hannesduske/Fast_SiPM_Photodetector/03_Design/PCB Desing Calculations.pdf

### LMR516XX Output Voltage

### R ¹º 13 kΩ 1

### R ¹º 1,8 kΩ 2

V ¹º 0,8 V out,ref,LMR516XX

¹º | * V | = 6,5778 V out,ref,LMR516XX + 1
R2

R1 Vout,LMR516XX

¹º | = 0,4444 mA
+ R2

R1

Vout,LMR516XX I

### LMR516XX Enable Threshold

### R ¹º 36 kΩ 1

### R ¹º 2 kΩ 2

V ¹º 1,227 V en,ref,LMR516XX

¹º | * V | = 23,313 V
| R en,ref,LMR516XX
2

+ R2

R1 Ven,LMR516XX

### LT8365 Output Voltage

### R1 ¹º 36 kΩ

### R2 ¹º 2 kΩ

V ¹º 1,6 V out,ref,LT8365

¹º | * V | = 30,4 V out,ref,LT8365 + 1
R2

R1 Vout,LT8365

¹º | = 0,8 mA
+ R2

R1

Vout,LT8365 I

### LT8365 Enable Threshold

### R ¹º 100 kΩ 1

### R ¹º 27 kΩ 2

V ¹º 1,6 V en,ref,LT8365

¹º | * V | = 7,5259 V
| R en,ref,LT8365
2

+ R2

R1 Ven,LT8365

### NCP731 Output Voltage Range

### R ¹º 100 kΩ 1

### R ¹º 4,3 kΩ 2,fix

R ¹º 1 kΩ 2,adj

V ¹º 1,2 V out,ref,NCP731

¹º | * V | = 23,8415 V out,ref,NCP731 + 1
+ R2,adj

R2,fix

R1 Vout,low,NCP731

¹º | * V | = 29,107 V out,ref,NCP731 + 1
R2,fix

R1 Vout,high,NCP731

¹º | = 0,2292 mA
+ R2

R1

Vout,high,NCP731 I

### GALI S66+

### I ¹º 18 mA S66

### V ¹º 3,5 V S66

¹º | = 170,9877 Ω
IS66
- VS66

Vout,LMR516XX RS66

¹º | * I | = 55,4 mW S66
- VS66

Vout,LMR516XX

PR,bias
