hannesduske/Fast_SiPM_Photodetector/01_Docs/01_Img/output_noise_floor.png

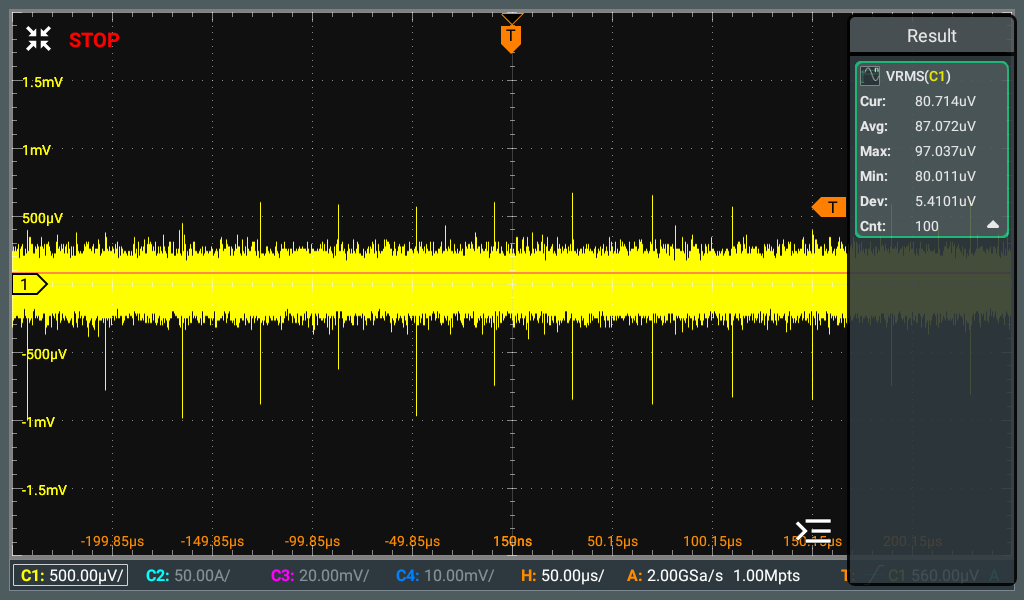
01_Docs/01_Img/output_noise_floor.png
