hannesduske/Fast_SiPM_Photodetector/01_Docs/01_Img/pcb_v0_2_asm.png

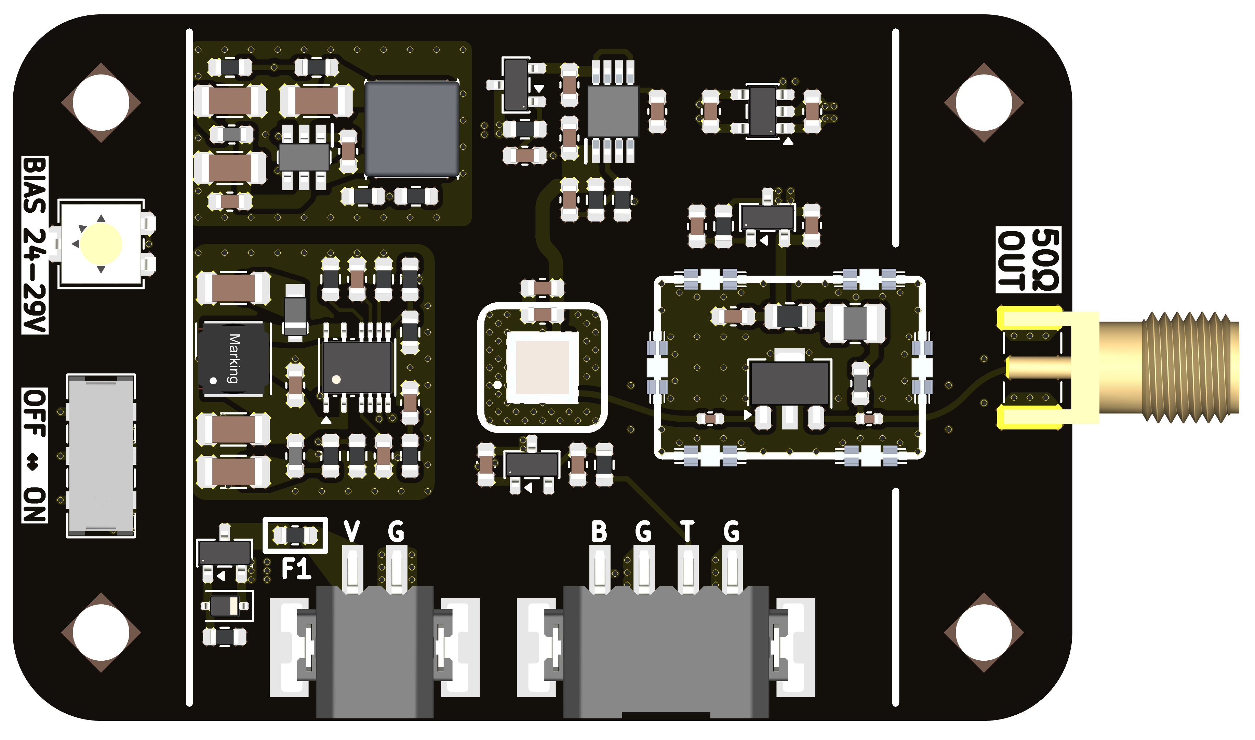
01_Docs/01_Img/pcb_v0_2_asm.png
