hannesduske/Fast_SiPM_Photodetector/02_PCB/Fast_SiPM_Photodetector/Fabrication/V0.2/Fast_SiPM_Photodetector-V0.2-bom.csv

Designator | Footprint | Quantity | Value | LCSC Part #
C1, C10, C2, C27, C28, C7 | 1206 | 6 | 10u;50V
C11, C13, C17, C18, C23, C24 | 0603 | 6 | 2.2u;35V
C12, C19, C25, C29, C3, C9 | 0603 | 6 | 100n;100V
C14, C15, C16, C21, C26 | 0603 | 5 | 10n;100V
C20, C22 | 0402 | 2 | 10nF;25V;C0G
C4 | 0603 | 1 | 1u;16V
C5 | 0603 | 1 | 1n;16V
C6 | 0603 | 1 | 220n;16V
D1 | D_SOD-323 | 1 | SZMM3Z10VT1G
D2 | SMD115PBQTP | 1 | RB021VAM90TR
F1 | 0603 | 1 | MFU0603FF03000
FB1, FB3 | 0603 | 2 | BLM18AG601SN1D
IC1 | Analog_MSOP-12-16-1EP_3x4.039mm_P0.5mm_EP1.651x2.845mm | 1 | LT8365JMSE
IC2 | SOT95P280X145-6N | 1 | LMR51606XFDBVR
IC3 | MICROFC30035SMTTR1 | 1 | MICROFC-30035-SMT-TR1
IC4 | SOP65P488X110-9N | 1 | NCP731ADNADJR2G
J1 | PTSM 0,5 2-HH-2,5-SMD R32 | 1 | PTSM 0,5/ 2-HH-2,5-SMD R32
J2 | SMA_Samtec_SMA-J-P-H-ST-EM1_EdgeMount | 1 | SMA
J3 | PTSM 0,5 4-HH-2,5-SMD R32 | 1 | PTSM 0,5/ 4-HH-2,5-SMD R32
L1 | L_Wurth_WE-LQSH-4020 | 1 | 7443732448100
L2 | L_Wuerth_MAPI-5020-Custom | 1 | 74404052470
L3 | 1008 | 1 | 1008CS-222XGRC
L4 | 0603 | 1 | 0603HP-R10XGRW
MP1, MP2, MP3, MP4, MP5, MP6 | S094146R | 6 | S0941-46R
Q1 | SOT-23 | 1 | PJA3463_R1_00001
Q2, Q3 | SOT-23 | 2 | MMBT6427LT1G
R1, R13, R14, R16, R3, R7 | 0603 | 6 | 100k;1%
R10, R12, R6 | 0603 | 3 | 2k;1%
R11 | 0603 | 1 | 13k;1%
R15 | 0603 | 1 | 4.3k;1%
R17 | 0805 | 1 | 169;1%
R18 | 0603 | 1 | 10k;1%
R2 | 0603 | 1 | 91k;1%
R4 | 0603 | 1 | 130k;1%
R5, R9 | 0603 | 2 | 36k;1%
R8 | 0603 | 1 | 27k;1%
RV1 | Potentiometer_Bourns_3214J_Horizontal | 1 | 3314J-1-102
SW1 | SW_DPDT_CK_JS202011JCQN | 1 | JS202011JCQN
U1 | SOT-89-3 | 1 | GALI-S66
U2 | SOT-23-5 | 1 | TLV70033DDCR
U3 | SOT-23 | 1 | MCP9700Ax-ETT
