hannesduske/Fast_SiPM_Photodetector/02_PCB/Fast_SiPM_Photodetector/Fabrication/V0.2/Fast_SiPM_Photodetector_V0.2.step

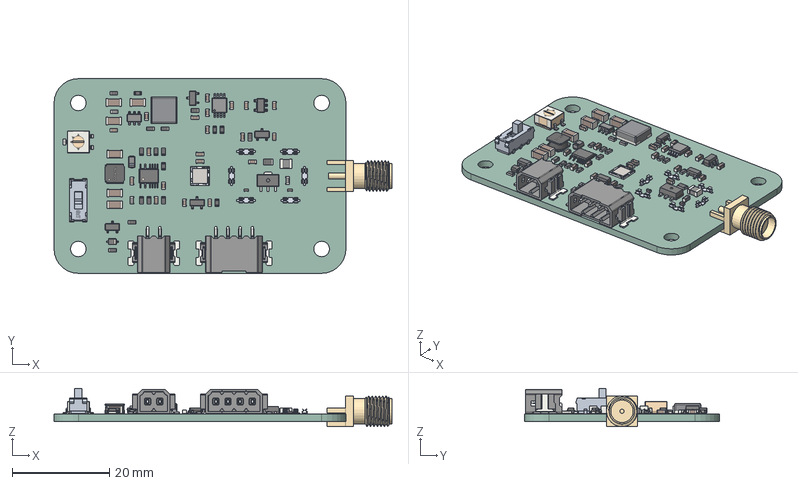
[picture p32: CAD file, 2026-10-15]
02_PCB/Fast_SiPM_Photodetector/Fabrication/V0.2/Fast_SiPM_Photodetector_V0.2.step
69.5 x 40.0 x 7.89 mm
Potentiometer_Bourns_3314G_Vertical
R_0603_1608Metric x 17
S0941-46R x 6
C_0603_1608Metric x 20
Analog_MSOP-12-16-1EP_3x4.039mm_P0.5mm_EP1.651x2.845mm
SOT-23 x 4
D_SOD-323
MICROFC-30035-SMT-TR1
C_1206_3216Metric x 6
Fuse_0603_1608Metric
L_0603_1608Metric x 3
adbeea57-9c39-11ed-93f0-dde97e994e83_part
adbeea58-9c39-11ed-93f0-dde97e994e83_part
adbeea59-9c39-11ed-93f0-dde97e994e83_part
BODY-SOT
LEAD-SOT x 6
L_Wuerth_MAPI-5020
C_0402_1005Metric x 2
PinsArrayLR
ThermalPad
L_1008_2520Metric
SOT-23-5
SMD115PBQ-TP
L_Wurth_WE-LQSH-4020
R_0805_2012Metric
JS202011JCQN_SW0001_PRT
SMA_Samtec_SMA-J-P-H-ST-EM1_EdgeMount
Fast_SiPM_Photodetector_PCB
