hannesduske/Fast_SiPM_Photodetector/02_PCB/Fast_SiPM_Photodetector/Fabrication/V0.1/Fast_SiPM_Photodetector-V0.1.step

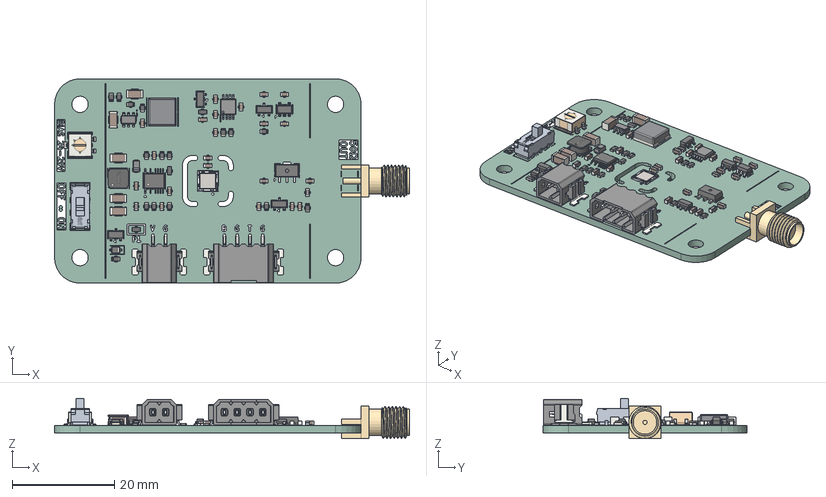
[picture p33: CAD file, 2026-10-15, an earlier design]
02_PCB/Fast_SiPM_Photodetector/Fabrication/V0.1/Fast_SiPM_Photodetector-V0.1.step
69.5 x 40.0 x 7.89 mm
Potentiometer_Bourns_3314G_Vertical
R_0603_1608Metric x 18
C_0603_1608Metric x 21
Analog_MSOP-12-16-1EP_3x4.039mm_P0.5mm_EP1.651x2.845mm
SOT-23 x 4
D_SOD-323
C_1206_3216Metric x 5
MICROFC-30035-SMT-TR1
Fuse_0603_1608Metric
L_0603_1608Metric x 2
adbeea57-9c39-11ed-93f0-dde97e994e83_part
adbeea58-9c39-11ed-93f0-dde97e994e83_part
adbeea59-9c39-11ed-93f0-dde97e994e83_part
BODY-SOT
LEAD-SOT x 6
L_Wuerth_MAPI-5020
PinsArrayLR
ThermalPad
SOT-23-5
SMD115PBQ-TP
L_Wurth_WE-LQSH-4020
JS202011JCQN_SW0001_PRT
SMA_Samtec_SMA-J-P-H-ST-EM1_EdgeMount
SinglePhotonDetector-unsaved-export-c5Gd0f_silkscreen x 2
SinglePhotonDetector-unsaved-export-c5Gd0f_PCB
