hannesduske/Fast_SiPM_Photodetector/02_PCB/Fast_SiPM_Photodetector/Fabrication/V0.2/Fast_SiPM_Photodetector-V0.2-top.jpg

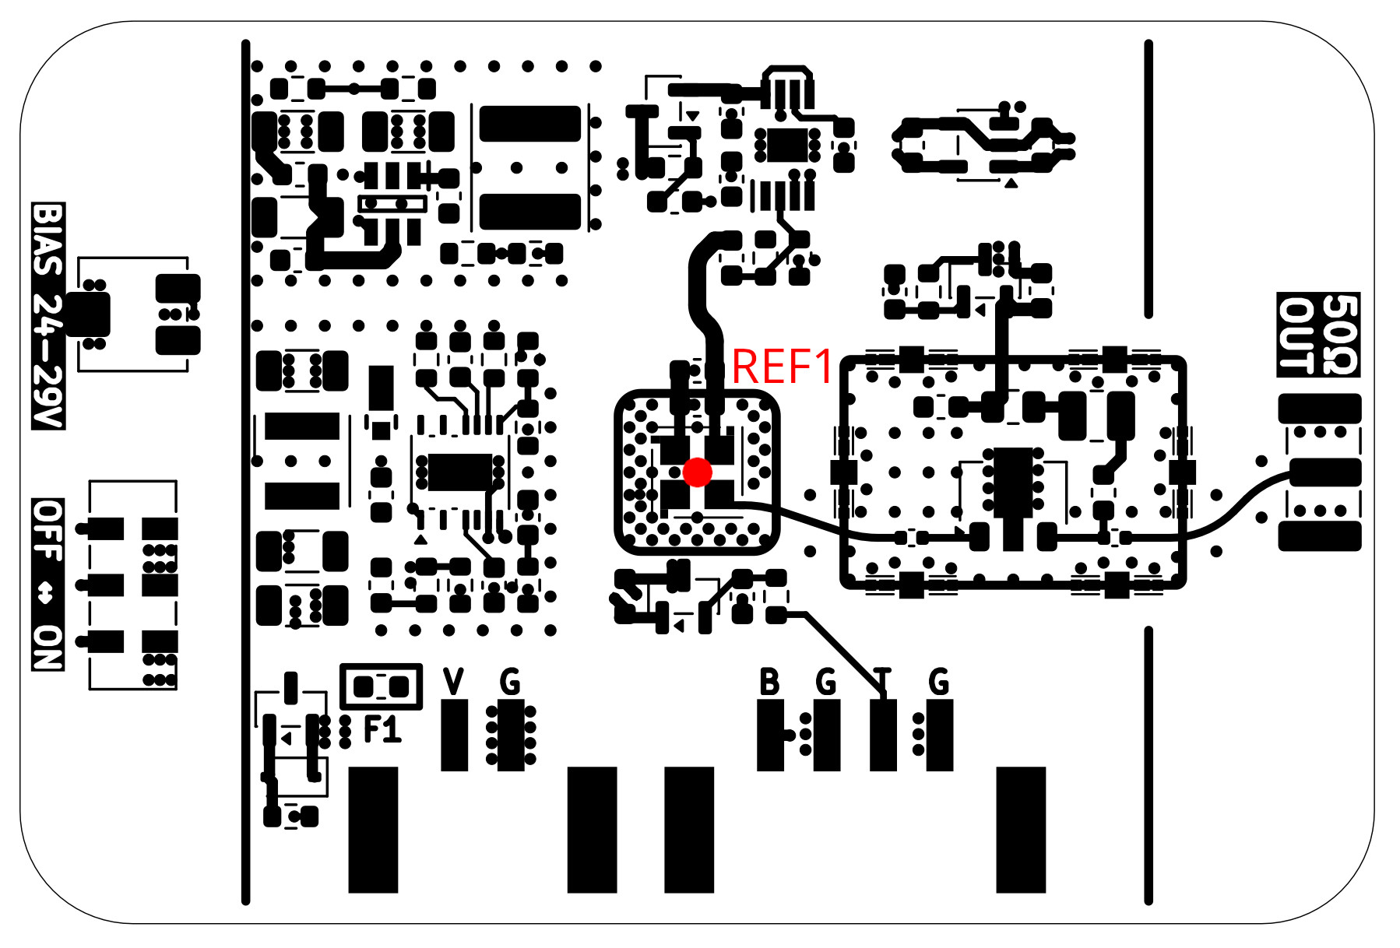
02_PCB/Fast_SiPM_Photodetector/Fabrication/V0.2/Fast_SiPM_Photodetector-V0.2-top.jpg
