hannesduske/Fast_SiPM_Photodetector/04_Evaluation/00_Single_Photon_Detection/single_photon.csv

Bias Voltage [V] | Single Photon Signal Amplitude [mV]
26 | 1
26.5 | 1.4
27 | 1.7
27.5 | 2
28 | 2.4
28.5 | 2.8
29 | 3.1
