hannesduske/Fast_SiPM_Photodetector/04_Evaluation/01_Dark_Count/dark_count.csv

Timebase (µs) | 20
Dark Count (count per 10 Timebase intervals)
Temp °C | 27 V | 28 V | 29 V
23 | 47.5 | 68.2 | 87
22 | 44 | 63.8 | 81.7
21 | 41 | 58.7 | 75.6
20 | 37.5 | 54.5 | 71.5
19 | 34.9 | 51 | 66.5
18 | 33 | 47.8 | 61.4
17 | 30.7 | 44.7 | 56.9
16 | 28.2 | 40.8 | 52.8
15 | 25.9 | 37.4 | 50
14 | 24.1 | 34 | 46.5
13 | 22.5 | 31.9 | 43.8
12 | 20.4 | 30.3 | 40.5
11 | 19.4 | 28.5 | 37.4
10 | 18.2 | 26.3 | 35.8
9 | 17 | 24.7 | 34
