hannesduske/Fast_SiPM_Photodetector/03_Design/capacitor_multiplier.asc

C1: cap; 4.7µ
C2: cap; 1µ
C3: cap; 10µ
Q1: npn
R1: res; 200k
R2: res; 9k
R3: res; 5k
R4: res; 100k
U1: ADM7171
V1: voltage; SINE(33 100m 330k)
Named nets: 0, OUT
.tran 50u
