hannesduske/Fast_SiPM_Photodetector/02_PCB/Fast_SiPM_Photodetector/Fast_SiPM_Photodetector.kicad_pcb

## KiCad design 02_PCB/Fast_SiPM_Photodetector/Fast_SiPM_Photodetector.kicad_pcb (2026-10-14)

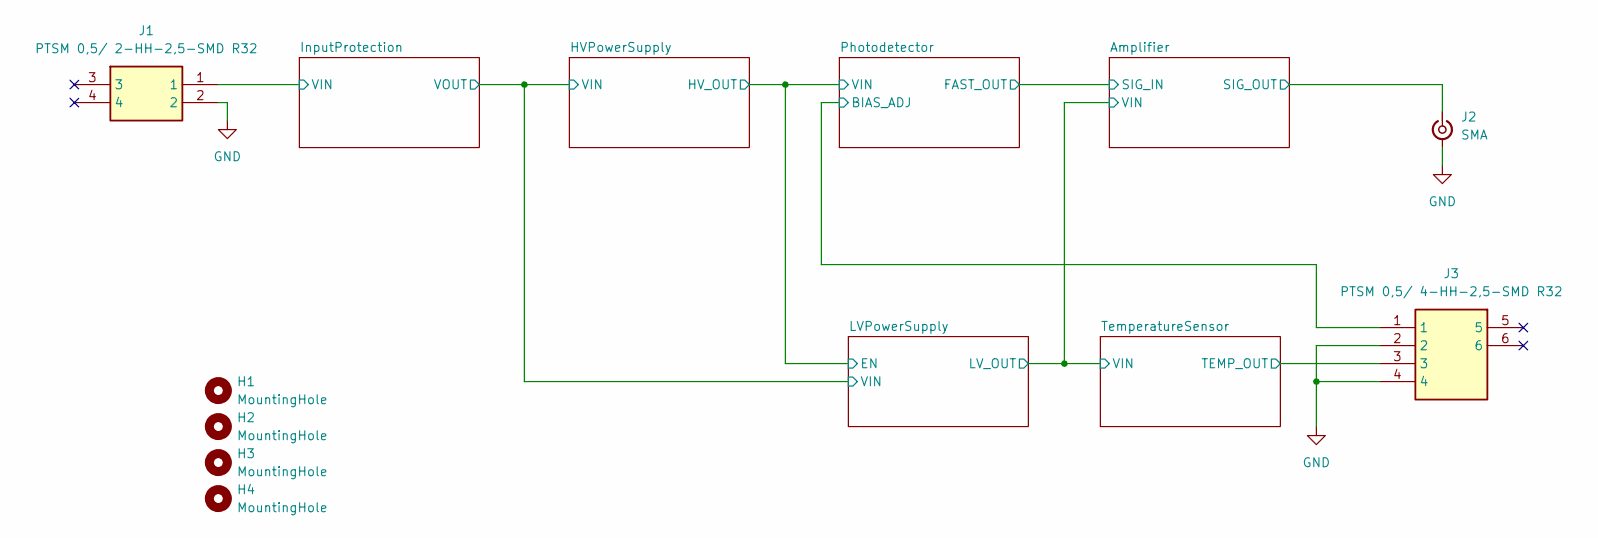
[picture p42: schematic Fast_SiPM_Photodetector.kicad_sch, Fast SiPM Photodetector]

Parts:
H1, H2, H3, H4: MountingHole; MountingHole_3.2mm_M3
J1: PTSM 0,5/ 2-HH-2,5-SMD R32; PTSM 0,5 2-HH-2,5-SMD R32; Mouser Part Number 651-1778764
J2: SMA; SMA_Samtec_SMA-J-P-H-ST-EM1_EdgeMount
J3: PTSM 0,5/ 4-HH-2,5-SMD R32; PTSM 0,5 4-HH-2,5-SMD R32; Mouser Part Number 651-1778780

Connections:
/Amplifier/SIG_OUT: J2.1 (In); also elsewhere on the board
/InputProtection/VIN: J1.1; also elsewhere on the board
/Photodetector/BIAS_ADJ: J3.1; also elsewhere on the board
/TemperatureSensor/TEMP_OUT: J3.3; also elsewhere on the board
GND: J1.2, J2.2 (Ext), J3.2, J3.4; also elsewhere on the board

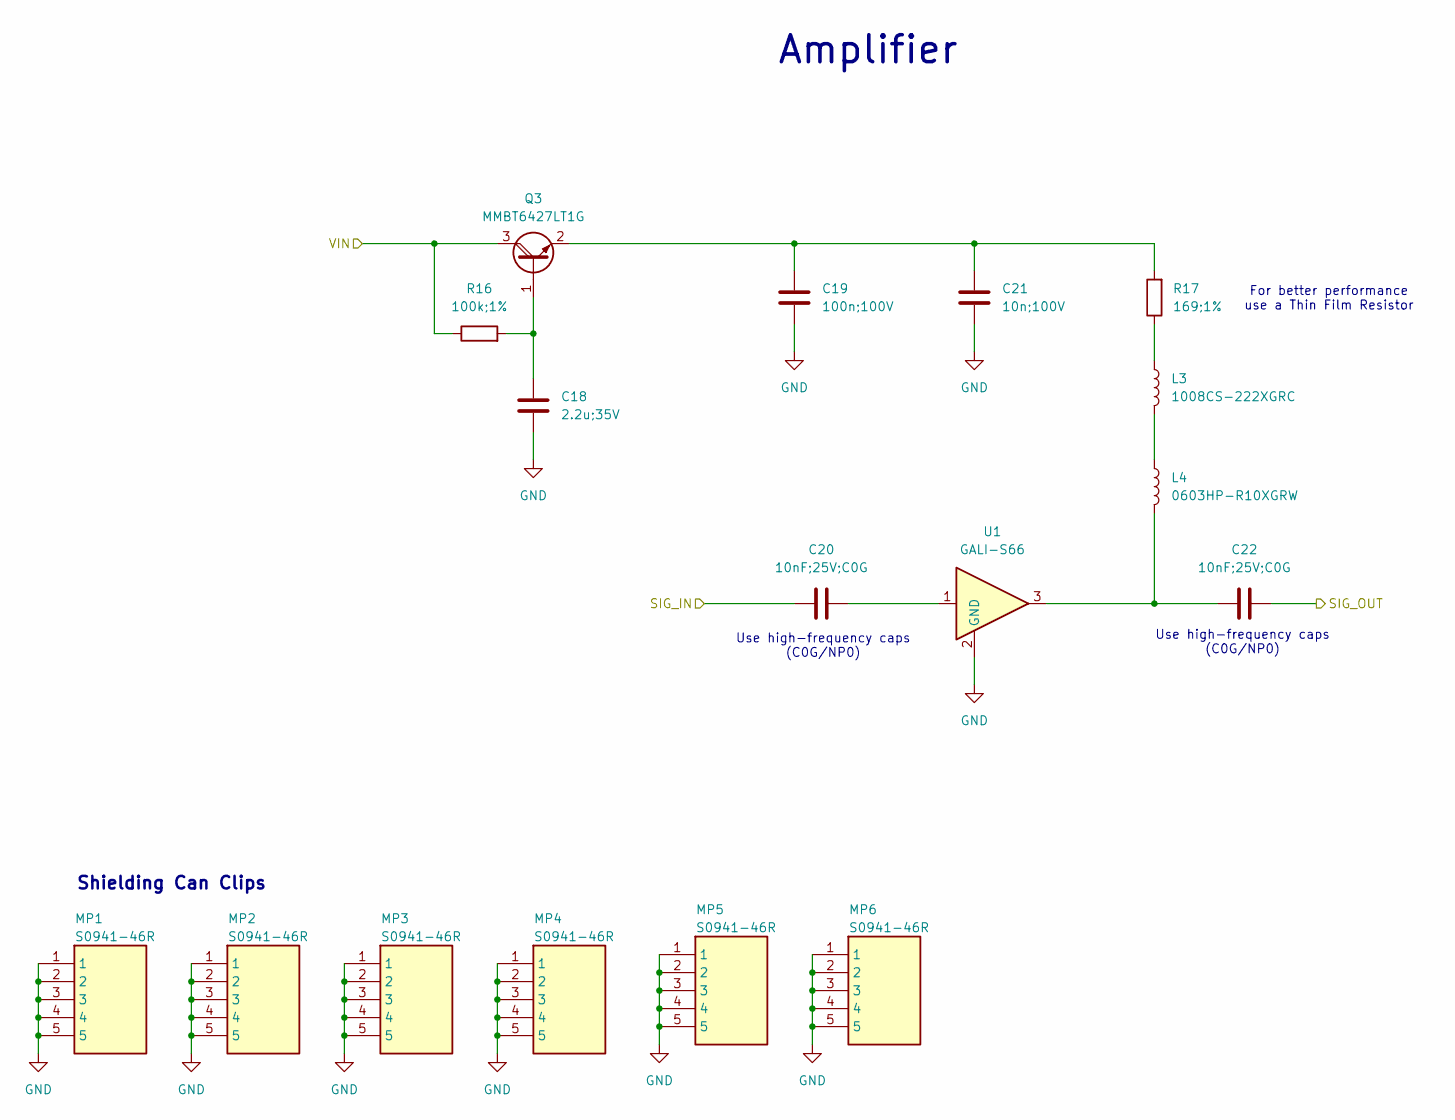
[picture p43: schematic Amplifier.kicad_sch, Fast SiPM Photodetector]

Parts:
C18: 2.2u;35V; C_0603_1608Metric
C19: 100n;100V; C_0603_1608Metric
C20, C22: 10nF;25V;C0G; C_0402_1005Metric
C21: 10n;100V; C_0603_1608Metric
L3: 1008CS-222XGRC; L_1008_2520Metric
L4: 0603HP-R10XGRW; L_0603_1608Metric
MP1, MP2, MP3, MP4, MP5, MP6: S0941-46R; S094146R; Mouser Part Number 855-S0941-46R
Q3: MMBT6427LT1G; SOT-23
R16: 100k;1%; R_0603_1608Metric
R17: 169;1%; R_0805_2012Metric
U1: GALI-S66; SOT-89-3

Connections:
/Amplifier/SIG_IN: C20.1; also elsewhere on the board
/Amplifier/SIG_OUT: C22.2; also elsewhere on the board
/LVPowerSupply/LV_OUT: Q3.3 (C), R16.1; also elsewhere on the board
GND: C18.2, C19.2, C21.2, MP1.1, MP1.2, MP1.3, MP1.4, MP1.5, MP2.1, MP2.2, MP2.3, MP2.4, MP2.5, MP3.1, MP3.2, MP3.3, MP3.4, MP3.5, MP4.1, MP4.2, MP4.3, MP4.4, MP4.5, MP5.1, MP5.2, MP5.3, MP5.4, MP5.5, MP6.1, MP6.2, MP6.3, MP6.4, MP6.5, U1.2 (GND_2); also elsewhere on the board
unnamed: C20.2, U1.1
unnamed: C22.1, L4.2, U1.3
unnamed: L3.1, R17.1
unnamed: L3.2, L4.1
unnamed: C18.1, Q3.1 (B), R16.2
unnamed: C19.1, C21.1, Q3.2 (E), R17.2

Notes on the sheet:
Use high-frequency caps (C0G/NP0)
Shielding Can Clips
For better performance use a Thin Film Resistor
Amplifier

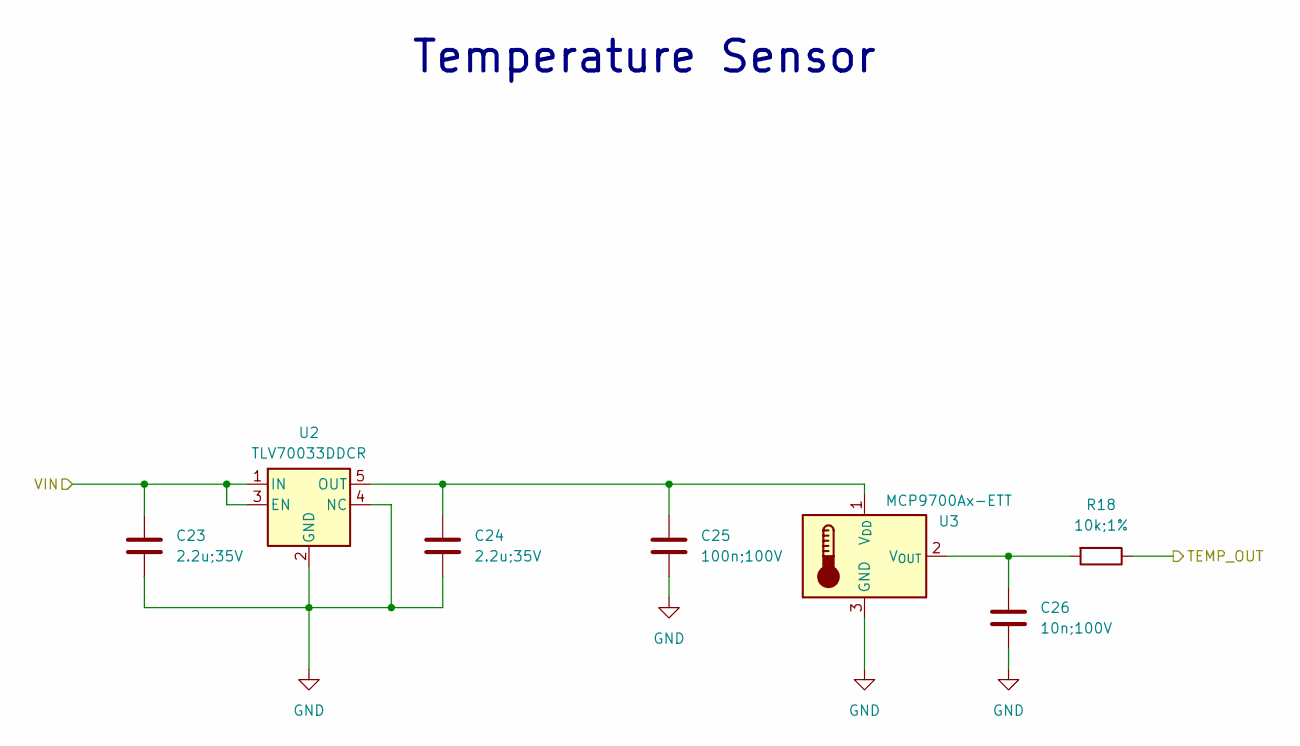
[picture p44: schematic TemperatureSensor.kicad_sch, Fast SiPM Photodetector]

Parts:
C23, C24: 2.2u;35V; C_0603_1608Metric
C25: 100n;100V; C_0603_1608Metric
C26: 10n;100V; C_0603_1608Metric
R18: 10k;1%; R_0603_1608Metric
U2: TLV70033DDCR; SOT-23-5
U3: MCP9700Ax-ETT; SOT-23

Connections:
/LVPowerSupply/LV_OUT: C23.1, U2.1 (IN), U2.3 (EN); also elsewhere on the board
/TemperatureSensor/TEMP_OUT: R18.1; also elsewhere on the board
GND: C23.2, C24.2, C25.2, C26.2, U2.2 (GND), U2.4 (NC), U3.3 (GND); also elsewhere on the board
unnamed: C24.1, C25.1, U2.5 (OUT), U3.1 (V_{DD})
unnamed: C26.1, R18.2, U3.2 (V_{OUT})

Notes on the sheet:
Temperature Sensor

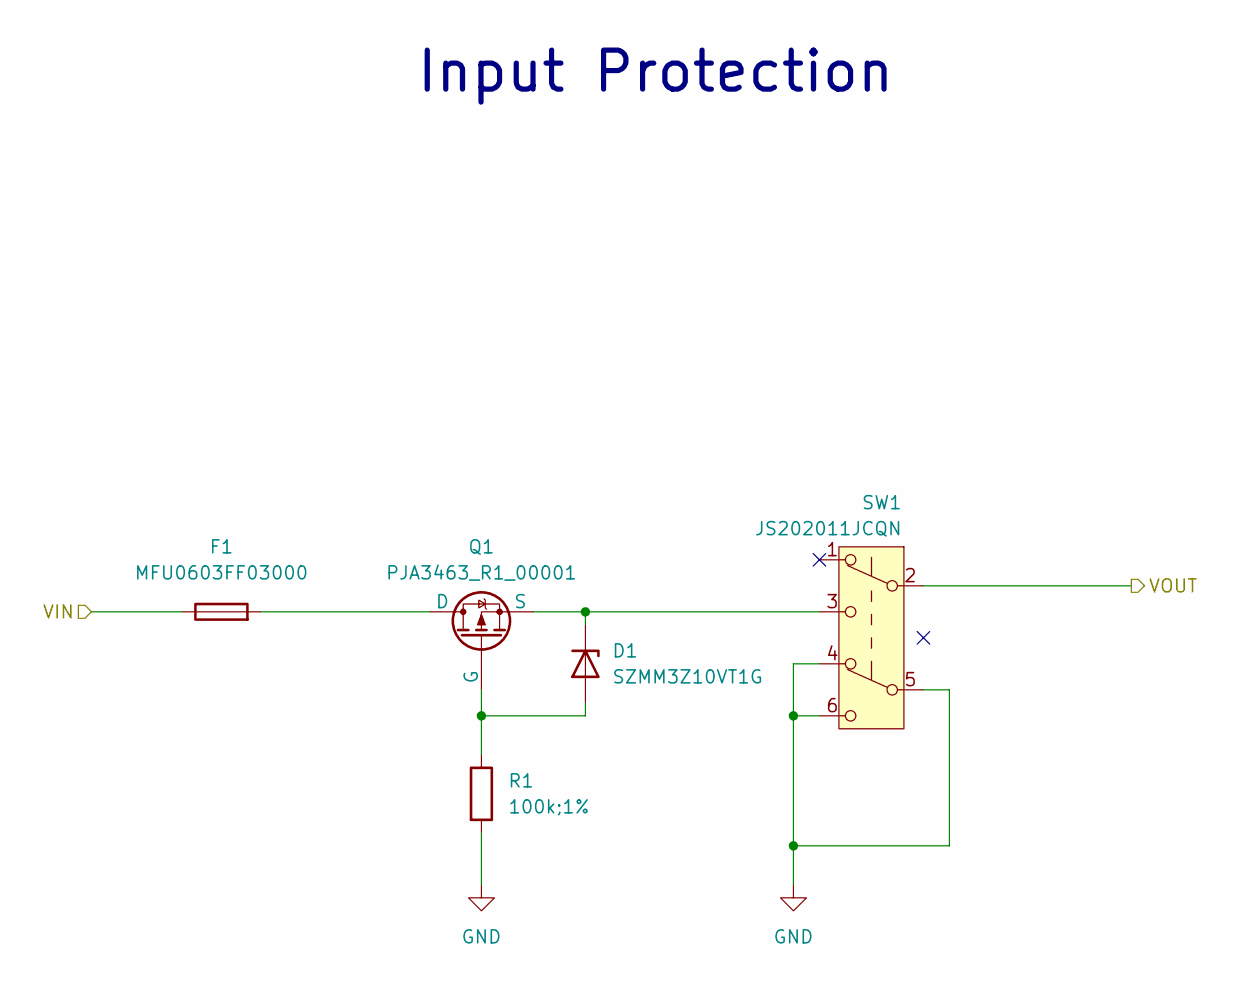
[picture p45: schematic InputProtection.kicad_sch, Fast SiPM Photodetector]

Parts:
D1: SZMM3Z10VT1G; D_SOD-323
F1: MFU0603FF03000; Fuse_0603_1608Metric
Q1: PJA3463_R1_00001; SOT-23
R1: 100k;1%; R_0603_1608Metric
SW1: JS202011JCQN; SW_DPDT_CK_JS202011JCQN

Connections:
/HVPowerSupply/VIN: SW1.2 (B); also elsewhere on the board
/InputProtection/VIN: F1.1; also elsewhere on the board
GND: R1.2, SW1.4 (A), SW1.5 (B), SW1.6 (C); also elsewhere on the board
unnamed: D1.2 (A), Q1.1 (G), R1.1
unnamed: D1.1 (K), Q1.2 (S), SW1.3 (C)
unnamed: F1.2, Q1.3 (D)

Notes on the sheet:
Input Protection

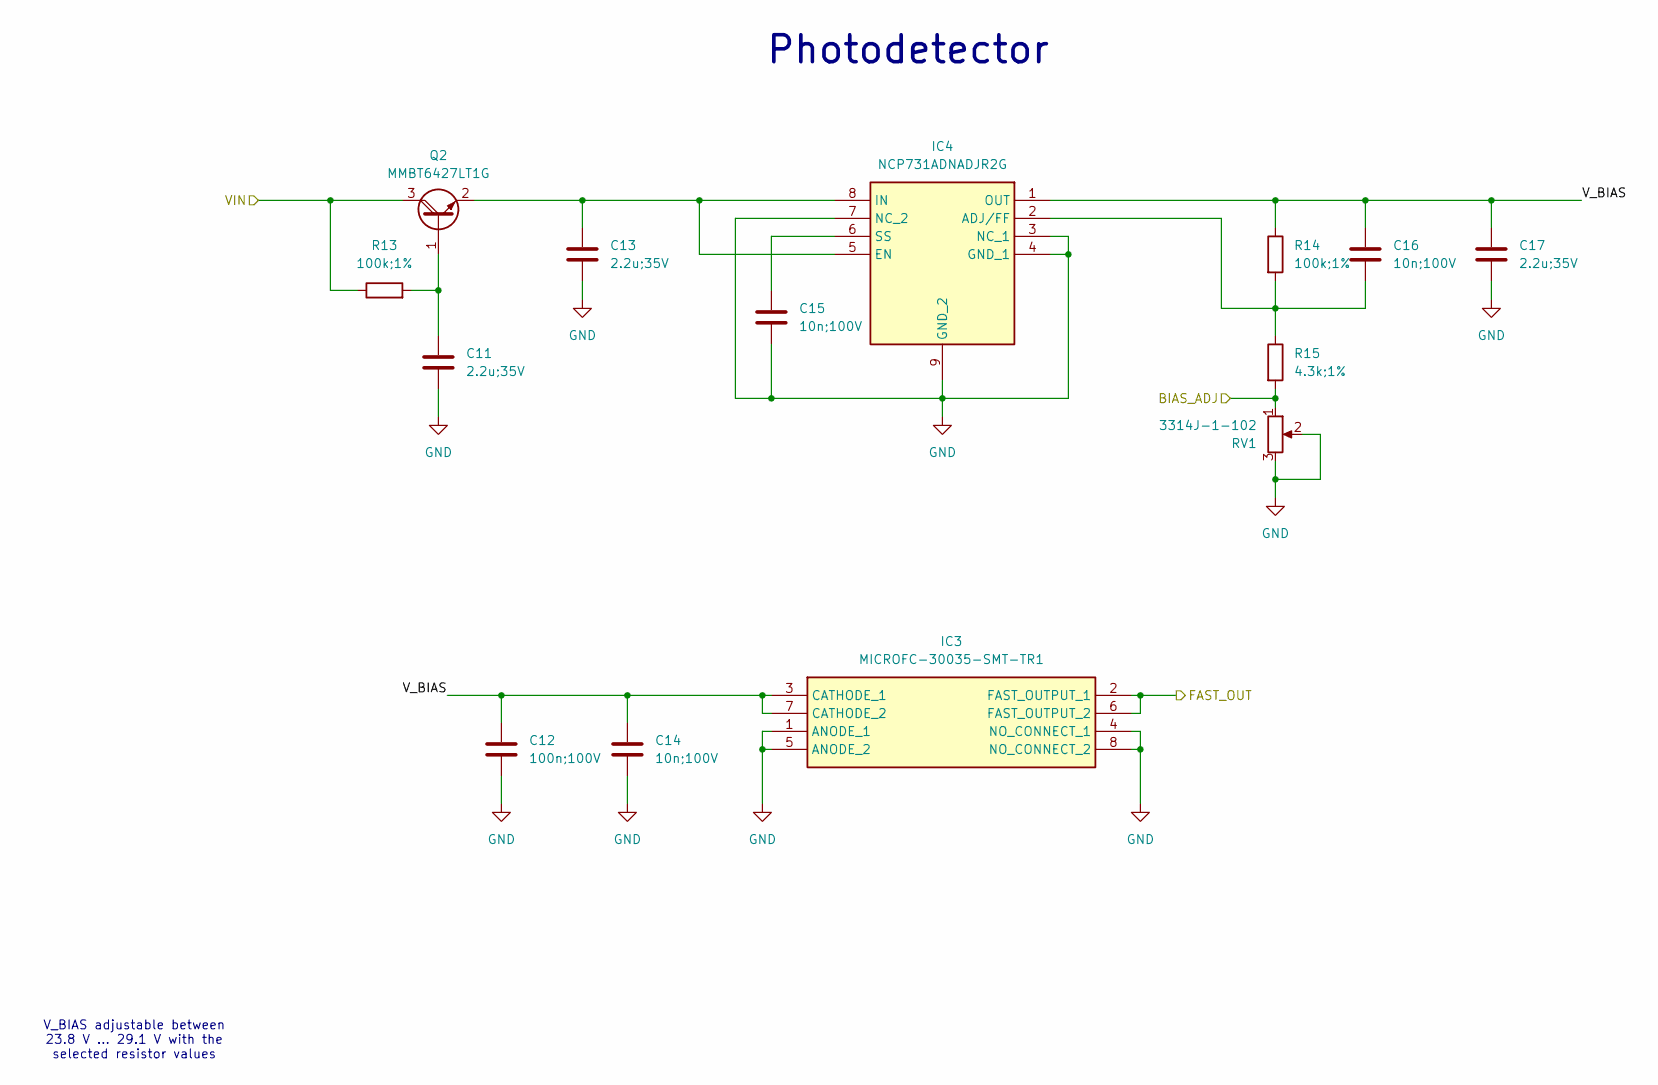
[picture p46: schematic Photodetector.kicad_sch, Fast SiPM Photodetector]

Parts:
C11, C13, C17: 2.2u;35V; C_0603_1608Metric
C12: 100n;100V; C_0603_1608Metric
C14, C15, C16: 10n;100V; C_0603_1608Metric
IC3: MICROFC-30035-SMT-TR1; MICROFC30035SMTTR1; Manufacturer_Part_Number MICROFC-30035-SMT-TR1; Mouser Part Number 863-MFC30035SMTTR1
IC4: NCP731ADNADJR2G; SOP65P488X110-9N; Mouser Part Number 863-NCP731ADNADJR2G
Q2: MMBT6427LT1G; SOT-23
R13, R14: 100k;1%; R_0603_1608Metric
R15: 4.3k;1%; R_0603_1608Metric
RV1: 3314J-1-102; Potentiometer_Bourns_3214J_Horizontal

Connections:
/Amplifier/SIG_IN: IC3.2 (FAST_OUTPUT_1), IC3.6 (FAST_OUTPUT_2); also elsewhere on the board
/HVPowerSupply/HV_OUT: Q2.3 (C), R13.1; also elsewhere on the board
/Photodetector/BIAS_ADJ: R15.2, RV1.1; also elsewhere on the board
/Photodetector/V_BIAS: C12.1, C14.1, C16.1, C17.1, IC3.3 (CATHODE_1), IC3.7 (CATHODE_2), IC4.1 (OUT), R14.1
GND: C11.2, C12.2, C13.2, C14.2, C15.2, C17.2, IC3.1 (ANODE_1), IC3.4 (NO_CONNECT_1), IC3.5 (ANODE_2), IC3.8 (NO_CONNECT_2), IC4.3 (NC_1), IC4.4 (GND_1), IC4.7 (NC_2), IC4.9 (GND_2), RV1.2, RV1.3; also elsewhere on the board
unnamed: C16.2, IC4.2 (ADJ/FF), R14.2, R15.1
unnamed: C13.1, IC4.5 (EN), IC4.8 (IN), Q2.2 (E)
unnamed: C15.1, IC4.6 (SS)
unnamed: C11.1, Q2.1 (B), R13.2

Notes on the sheet:
V_BIAS adjustable between 23.8 V ... 29.1 V with the selected resistor values
Photodetector

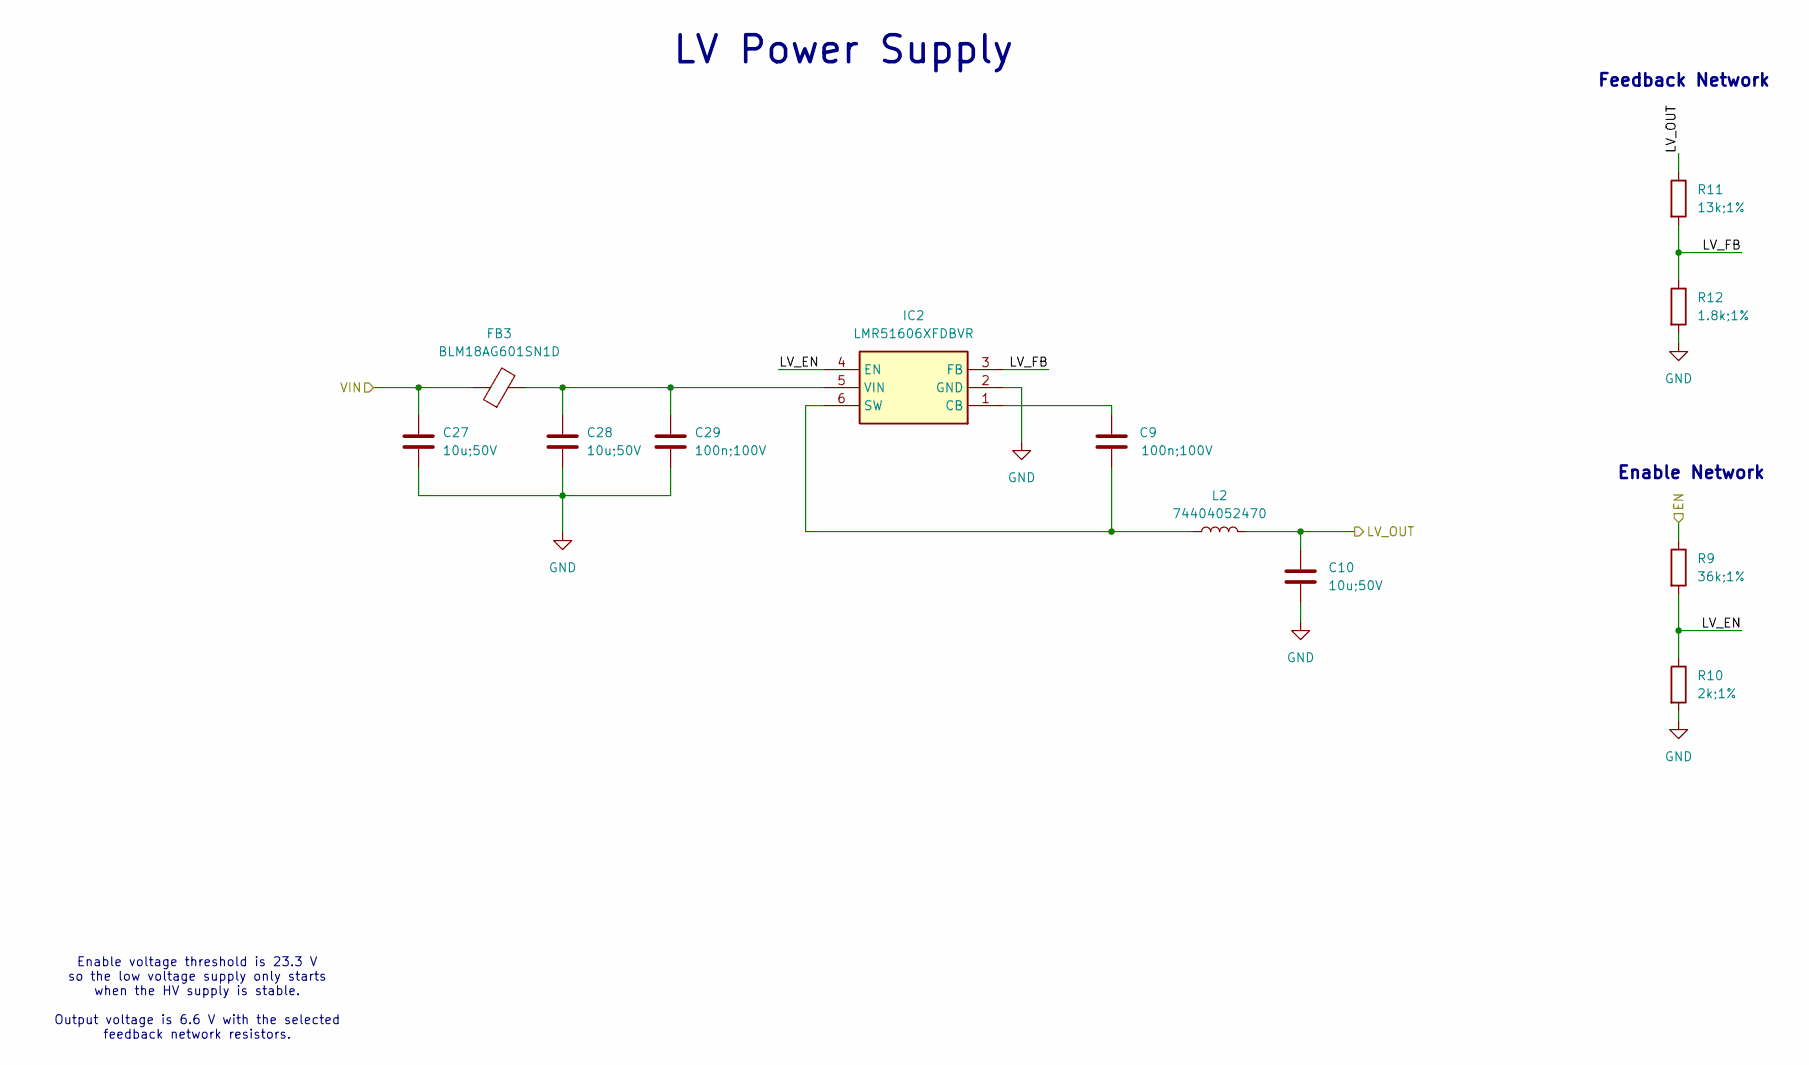
[picture p47: schematic LVPowerSupply.kicad_sch, Fast SiPM Photodetector]

Parts:
C9, C29: 100n;100V; C_0603_1608Metric
C10, C27, C28: 10u;50V; C_1206_3216Metric
FB3: BLM18AG601SN1D; L_0603_1608Metric
IC2: LMR51606XFDBVR; SOT95P280X145-6N; Mouser Part Number 595-LMR51606XDBVR
L2: 74404052470; L_Wuerth_MAPI-5020-Custom
R9: 36k;1%; R_0603_1608Metric
R10: 2k;1%; R_0603_1608Metric
R11: 13k;1%; R_0603_1608Metric
R12: 1.8k;1%; R_0603_1608Metric

Connections:
/HVPowerSupply/HV_OUT: R9.1; also elsewhere on the board
/HVPowerSupply/VIN: C27.2, FB3.1; also elsewhere on the board
/LVPowerSupply/LV_EN: IC2.4 (EN), R9.2, R10.1
/LVPowerSupply/LV_FB: IC2.3 (FB), R11.2, R12.1
/LVPowerSupply/LV_OUT: C10.1, L2.2, R11.1; also elsewhere on the board
GND: C10.2, C27.1, C28.1, C29.1, IC2.2 (GND), R10.2, R12.2; also elsewhere on the board
unnamed: C9.1, IC2.1 (CB)
unnamed: C9.2, IC2.6 (SW), L2.1
unnamed: C28.2, C29.2, FB3.2, IC2.5 (VIN)

Notes on the sheet:
Enable Network
Feedback Network
LV Power Supply
Enable voltage threshold is 23.3 V so the low voltage supply only starts when the HV supply is stable. Output voltage is 6.6 V with the selected feedback network resistors.

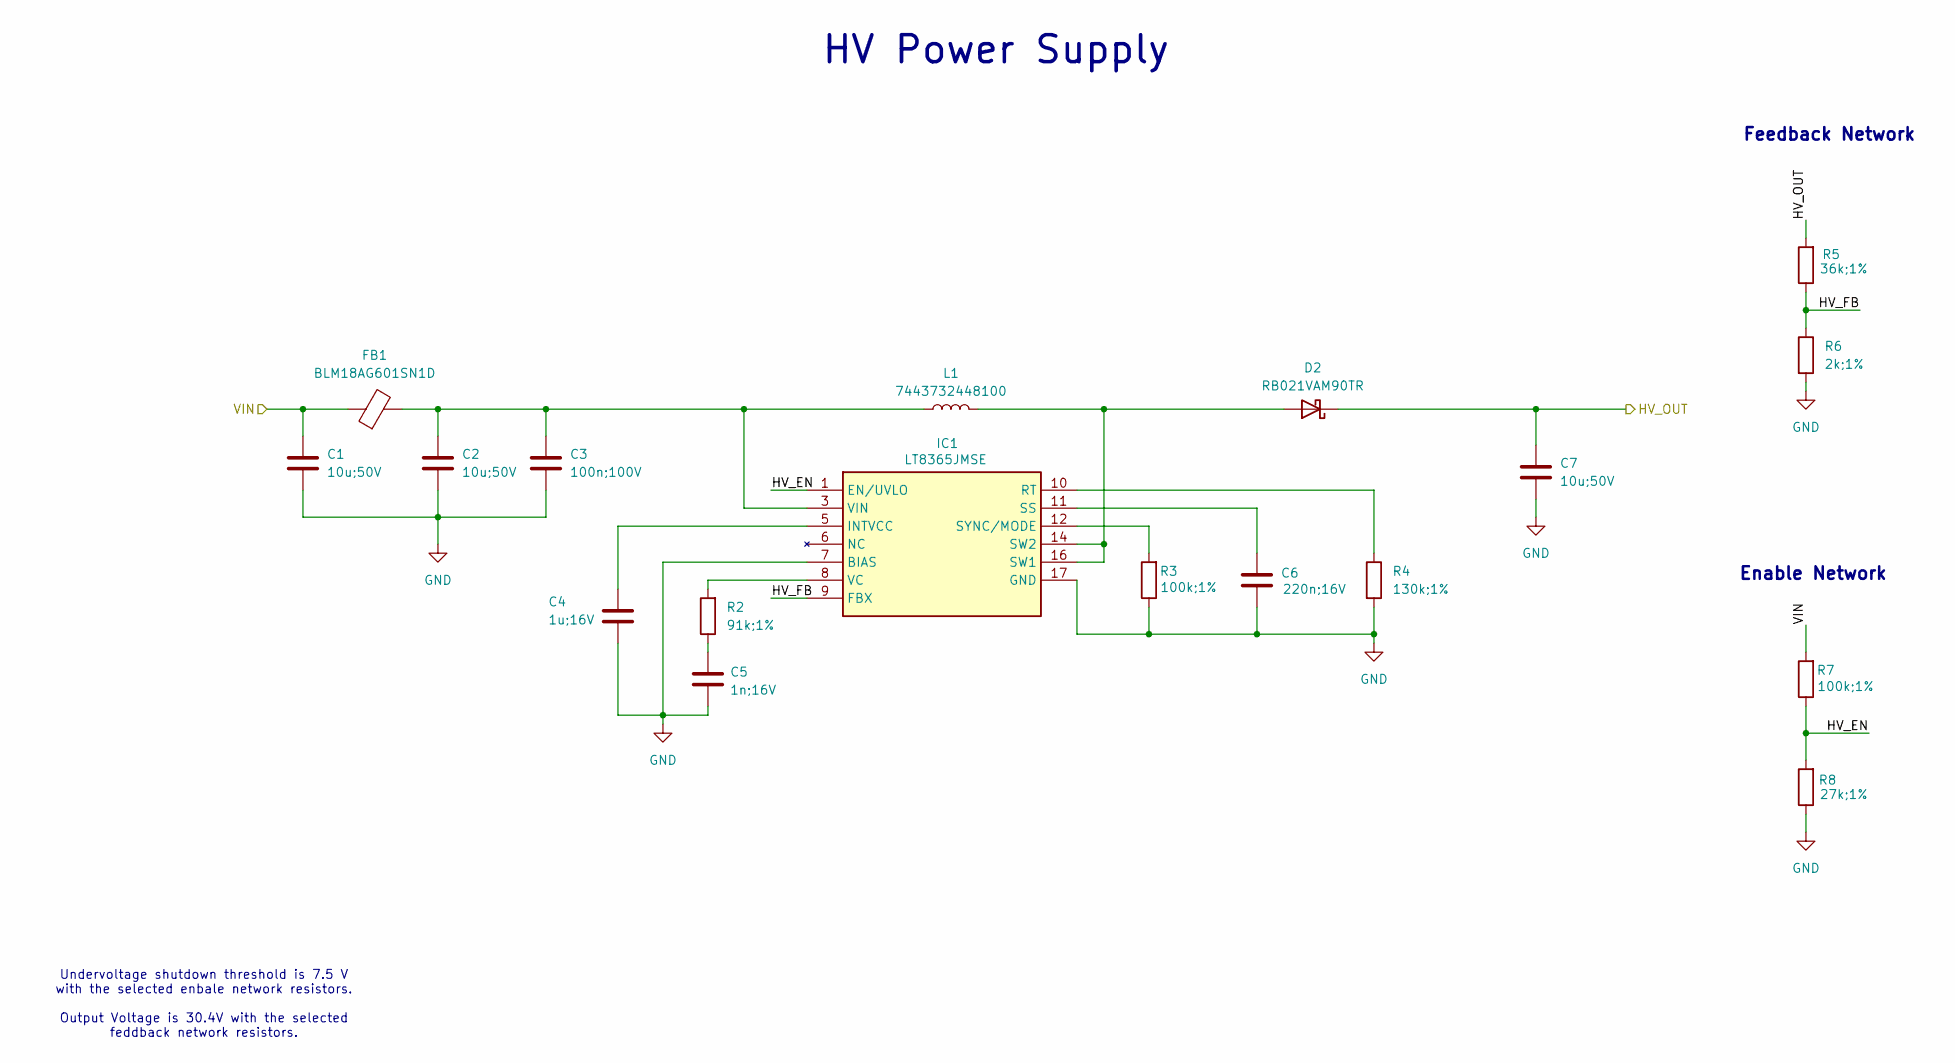
[picture p48: schematic HVPowerSupply.kicad_sch, Fast SiPM Photodetector]

Parts:
C1, C2, C7: 10u;50V; C_1206_3216Metric
C3: 100n;100V; C_0603_1608Metric
C4: 1u;16V; C_0603_1608Metric
C5: 1n;16V; C_0603_1608Metric
C6: 220n;16V; C_0603_1608Metric
D2: RB021VAM90TR; SMD115PBQTP
FB1: BLM18AG601SN1D; L_0603_1608Metric
IC1: LT8365JMSE; Analog_MSOP-12-16-1EP_3x4.039mm_P0.5mm_EP1.651x2.845mm; Mouser Part Number 584-LT8365JMSE
L1: 7443732448100; L_Wurth_WE-LQSH-4020
R2: 91k;1%; R_0603_1608Metric
R3, R7: 100k;1%; R_0603_1608Metric
R4: 130k;1%; R_0603_1608Metric
R5: 36k;1%; R_0603_1608Metric
R6: 2k;1%; R_0603_1608Metric
R8: 27k;1%; R_0603_1608Metric

Connections:
/HVPowerSupply/HV_EN: IC1.1 (EN/UVLO), R7.1, R8.2
/HVPowerSupply/HV_FB: IC1.9 (FBX), R5.1, R6.1
/HVPowerSupply/HV_OUT: C7.2, D2.1 (K), R5.2; also elsewhere on the board
/HVPowerSupply/VIN: C1.2, FB1.1, R7.2; also elsewhere on the board
GND: C1.1, C2.1, C3.1, C4.1, C5.1, C6.1, C7.1, IC1.7 (BIAS), IC1.17 (GND), R3.1, R4.2, R6.2, R8.1; also elsewhere on the board
unnamed: C5.2, R2.1
unnamed: D2.2 (A), IC1.14 (SW2), IC1.16 (SW1), L1.2
unnamed: C4.2, IC1.5 (INTVCC)
unnamed: IC1.10 (RT), R4.1
unnamed: C6.2, IC1.11 (SS)
unnamed: IC1.12 (SYNC/MODE), R3.2
unnamed: IC1.8 (VC), R2.2
unnamed: C2.2, C3.2, FB1.2, IC1.3 (VIN), L1.1

Notes on the sheet:
Undervoltage shutdown threshold is 7.5 V with the selected enbale network resistors. Output Voltage is 30.4V with the selected feddback network resistors.
Enable Network
HV Power Supply
Feedback Network

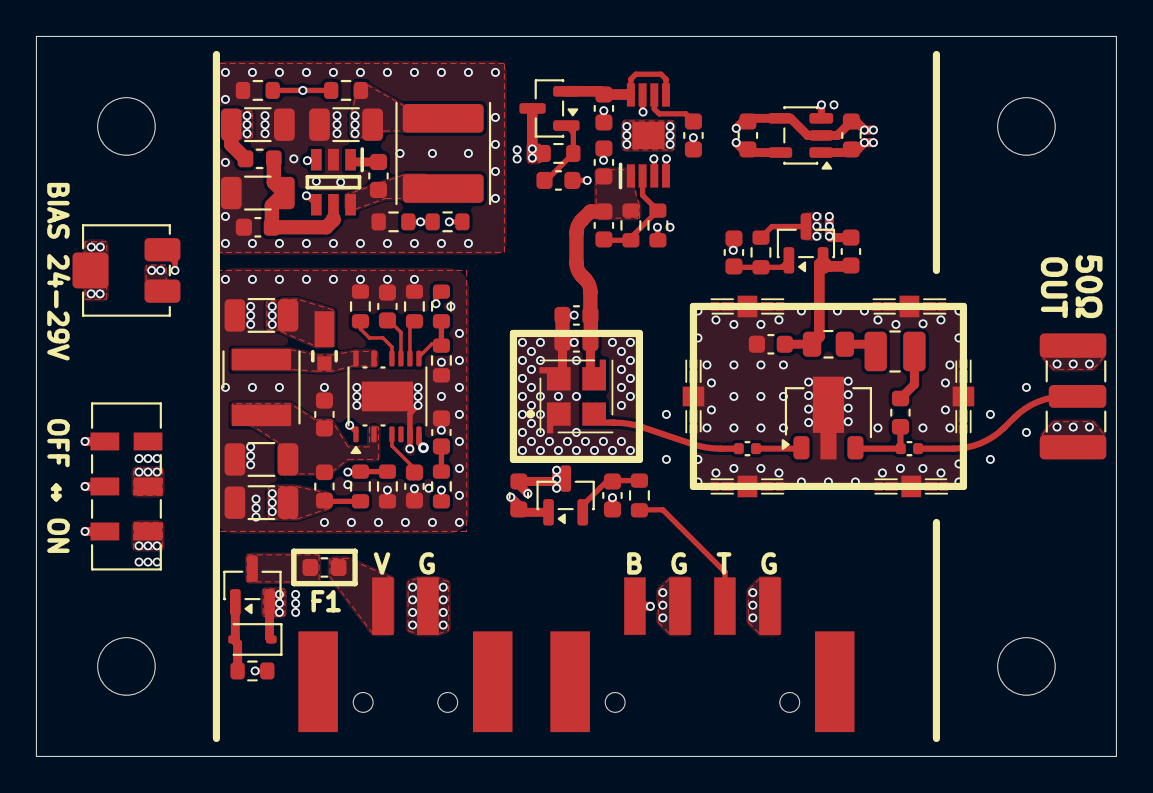
[picture p49: board Fast_SiPM_Photodetector.kicad_pcb from above]

Board: 4 copper layers, 60.0 x 40.0 mm, 80 parts (0 on the bottom side), 40 nets.
