hannesduske/Fast_SiPM_Photodetector/(commit log)

2026-10-14 chore: PCB V0.1 as ordered on 18.09.2026
2026-10-14 feat(detector): update schematic and pcb after first prototype
2026-10-14 chore: PCB V0.2 as ordered on 06.10.2026
